FTOD/GameGirl-DEV-HD/README.md

GameGirl Development version is the GameGirl with power supply only from DEBUG port and USB-C.

This design is under CERN Open Hardware Licence Version 2 - Permissive license.
Please refer to [License.txt](license.txt) and [cern_ohl_p.v2.howto.pdf](cern_ohl_p_v2_howto.pdf) for more detail.
