FTOD/GameGirl-DEV-HD/GameGirl-dev.pdf

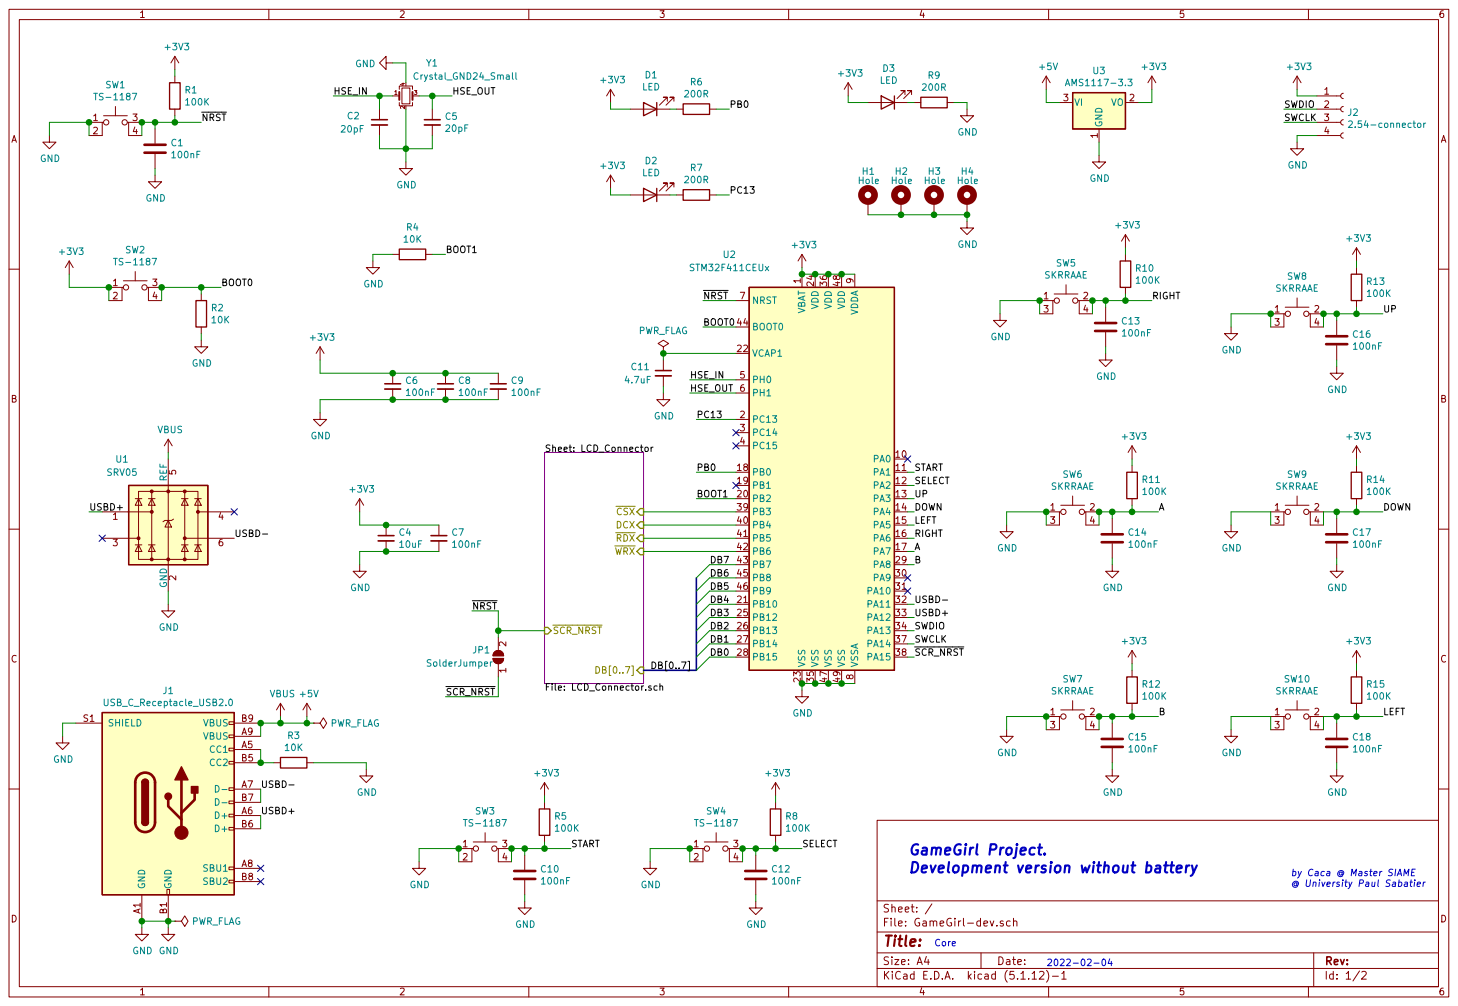
[picture p1: page 1]

1 VCAP1 22 VDD 24 VDD 36 VDD 48 VDDA

9 VSS 23 VSS 35 VSS 47 VSS 49 VSSA

LEFT SCR_NRST START B USBD+ USBD-

Development version without battery

by Caca @ Master SIAME
@ University Paul Sabatier

Id: 1/2 Title: File: GameGirl-dev.sch Sheet: /

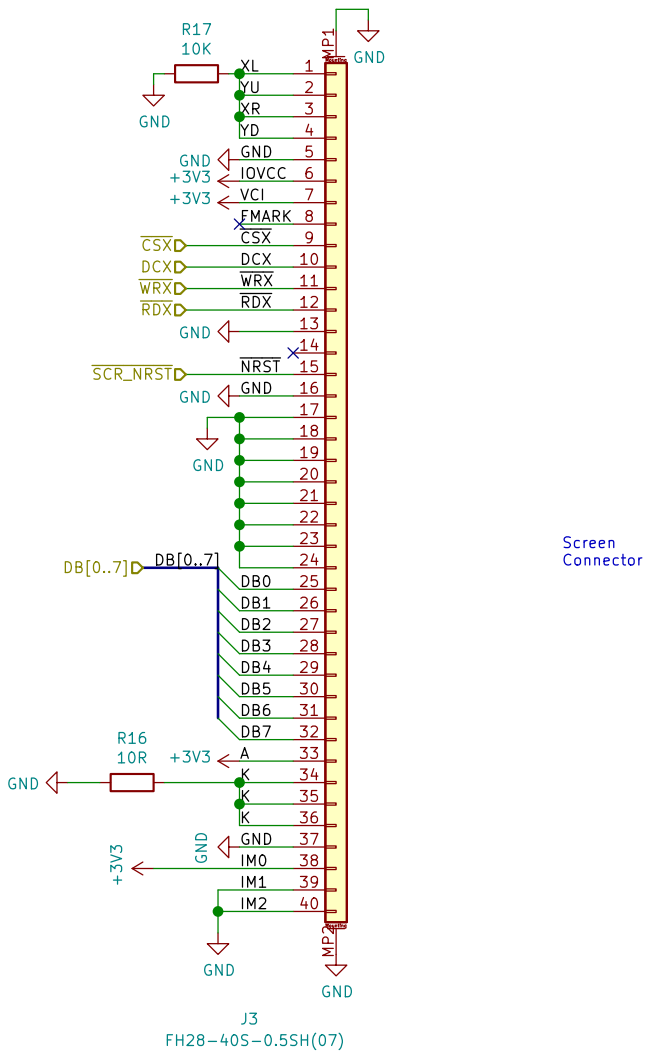
[picture p2: page 2]

GameGirl Project.
Development version without battery

by Caca @ Master SIAME
@ University Paul Sabatier
