FTOD/GameGirl-DEV-HD/GameGirl-dev.kicad_pcb

## KiCad design GameGirl-dev.kicad_pcb (2022-02-23)

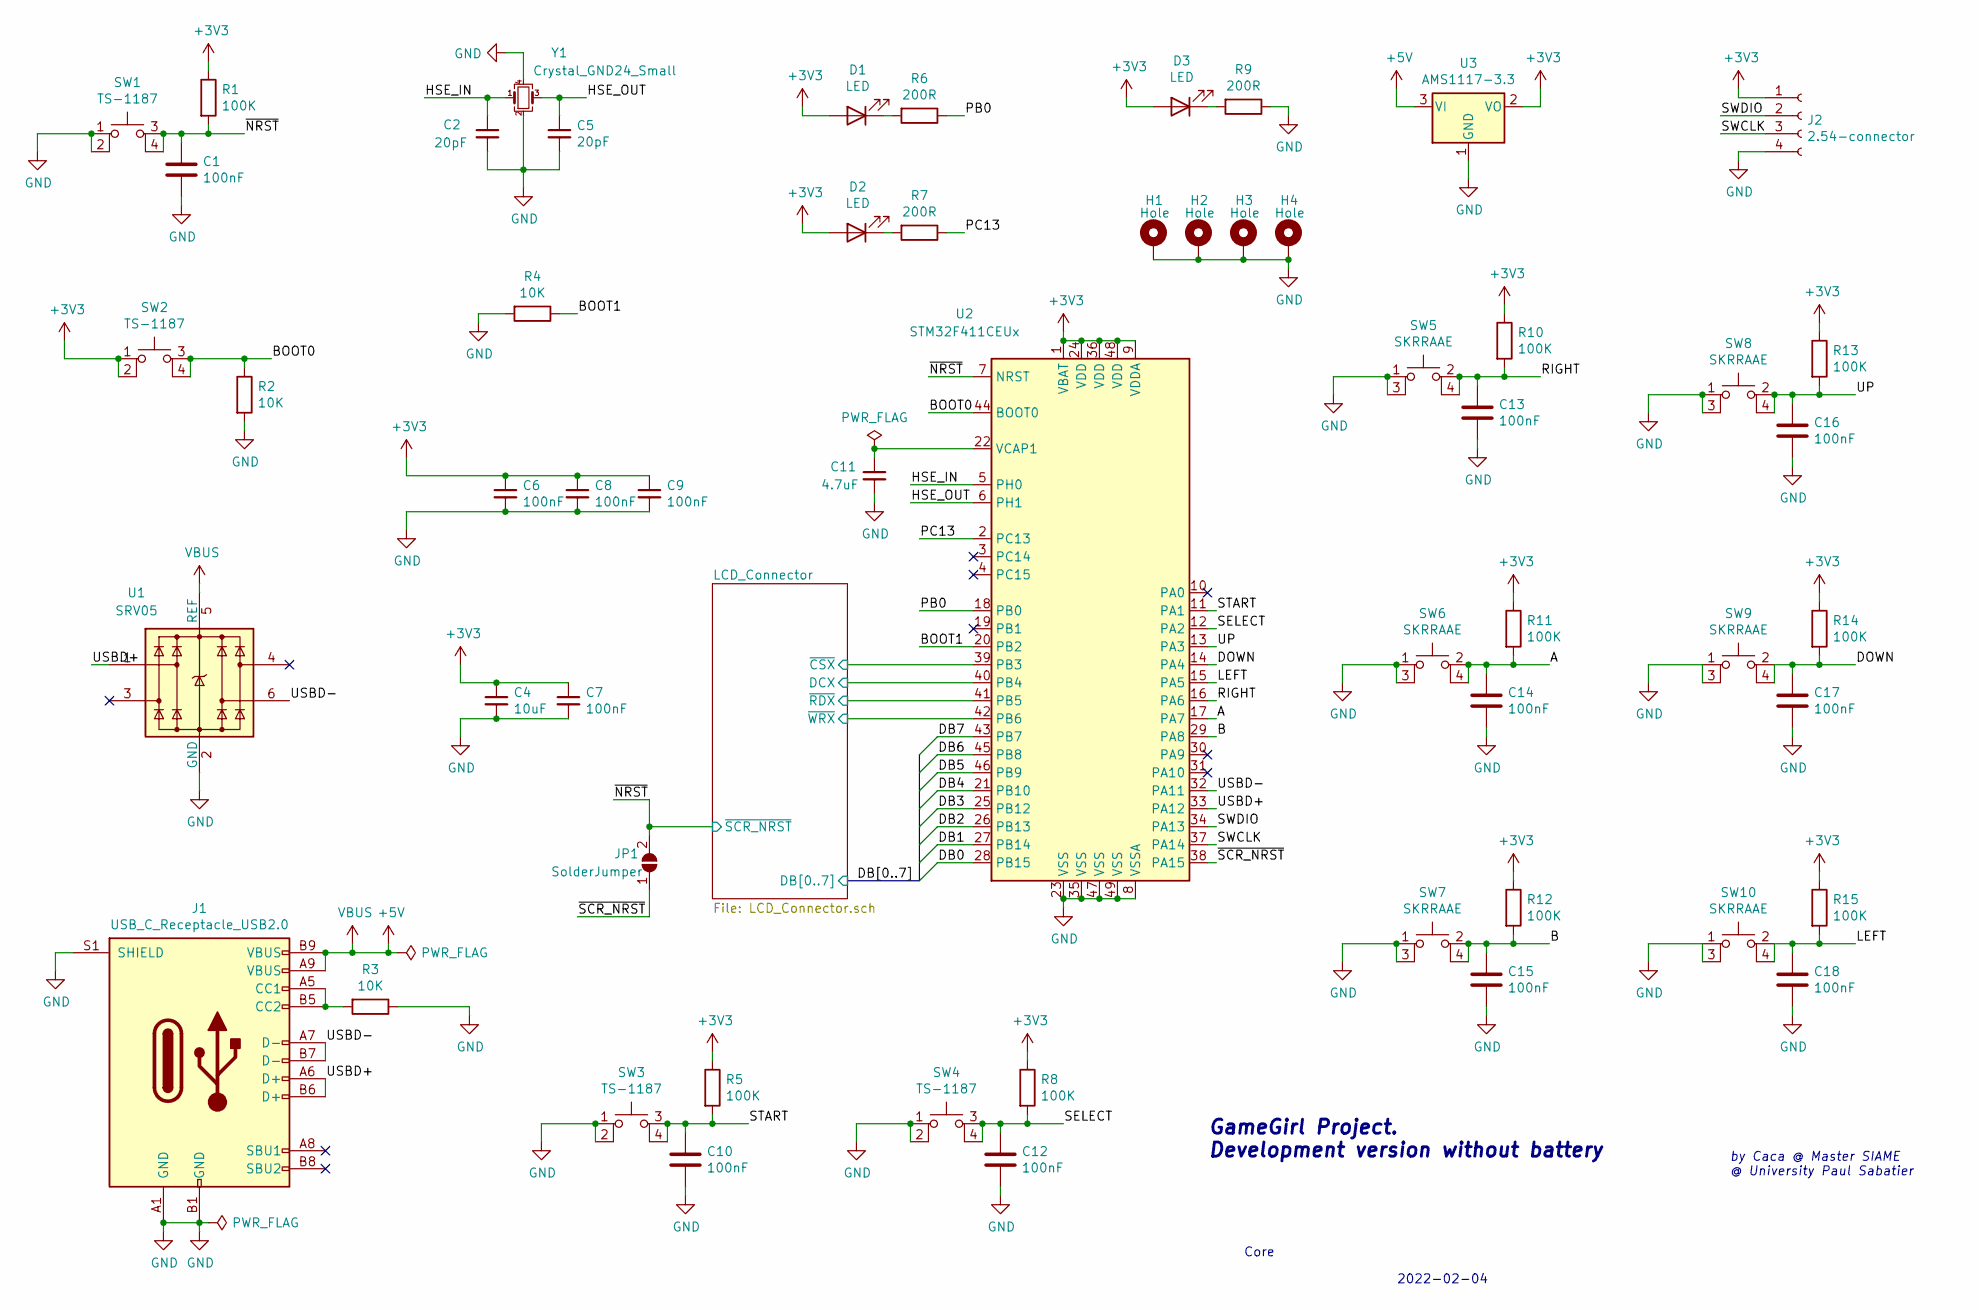
[picture p3: schematic GameGirl-dev.sch]

Parts:
C1, C6, C7, C8, C9, C10, C12, C13, C14, C15, C16, C17, C18: 100nF; C_0402_1005Metric
C2, C5: 20pF; C_0402_1005Metric
C4: 10uF; C_0805_2012Metric_Pad1.18x1.45mm_HandSolder
C11: 4.7uF; C_0805_2012Metric_Pad1.18x1.45mm_HandSolder
D1, D2: LED; LED_0603_1608Metric
D3: LED; LED_0805_2012Metric
H1, H2, H3, H4: Hole; MountingHole_3.2mm_M3_DIN965_Pad_TopBottom
J1: USB_C_Receptacle_USB2.0; USB_C_Receptacle_XKB_U262-16XN-4BVC11; LCSC C319148
J2: 2.54-connector; PinHeader_1x04_P2.54mm_Horizontal
JP1: SolderJumper; SolderJumper-2_P1.3mm_Open_TrianglePad1.0x1.5mm
R1, R5, R8, R10, R11, R12, R13, R14, R15: 100K; R_0402_1005Metric
R2, R3, R4: 10K; R_0402_1005Metric
R6, R7, R9: 200R; R_0402_1005Metric
SW1, SW2, SW3, SW4: TS-1187; TS1187ABAB; LCSC C318884
SW5, SW6, SW7, SW8, SW9, SW10: SKRRAAE; SKRR; LCSC C97437
U1: SRV05; SOT-23-6; LCSC C85364
U2: STM32F411CEUx; QFN-48-1EP_7x7mm_P0.5mm_EP5.6x5.6mm
U3: AMS1117-3.3; SOT-223
Y1: Crystal_GND24_Small; Crystal_SMD_3225-4Pin_3.2x2.5mm; LCSC C9006

Connections:
+3V3: C4.1, C6.1, C7.1, C8.1, C9.1, D1.2 (A), D2.2 (A), D3.2 (A), J2.1, R1.1, R5.1, R8.1, R10.1, R11.1, R12.1, R13.1, R14.1, R15.1, SW2.1 (A), SW2.2 (B), U2.1 (VBAT), U2.9 (VDDA), U2.24 (VDD), U2.36 (VDD), U2.48 (VDD), U3.2 (VO); also elsewhere on the board
+5V: J1.A4 (VBUS), J1.A9 (VBUS), J1.B4 (VBUS), J1.B9 (VBUS), U1.5 (REF), U3.3 (VI)
/A: C14.1, R11.2, SW6.2, SW6.4, U2.17 (PA7)
/B: C15.1, R12.2, SW7.2, SW7.4, U2.29 (PA8)
/BOOT0: R2.1, SW2.3 (C), SW2.4 (D), U2.44 (BOOT0)
/BOOT1: R4.1, U2.20 (PB2)
/DB0: U2.28 (PB15); also elsewhere on the board
/DB1: U2.27 (PB14); also elsewhere on the board
/DB2: U2.26 (PB13); also elsewhere on the board
/DB3: U2.25 (PB12); also elsewhere on the board
/DB4: U2.21 (PB10); also elsewhere on the board
/DB5: U2.46 (PB9); also elsewhere on the board
/DB6: U2.45 (PB8); also elsewhere on the board
/DB7: U2.43 (PB7); also elsewhere on the board
/DOWN: C17.1, R14.2, SW9.2, SW9.4, U2.14 (PA4)
/HSE_IN: C2.1, U2.5 (PH0), Y1.1
/HSE_OUT: C5.1, U2.6 (PH1), Y1.3
/LCD_Connector/DCX: U2.40 (PB4); also elsewhere on the board
/LCD_Connector/~CSX: U2.39 (PB3); also elsewhere on the board
/LCD_Connector/~RDX: U2.41 (PB5); also elsewhere on the board
/LCD_Connector/~WRX: U2.42 (PB6); also elsewhere on the board
/LEFT: C18.1, R15.2, SW10.2, SW10.4, U2.15 (PA5)
/PB0: R6.1, U2.18 (PB0)
/PC13: R7.1, U2.2 (PC13)
/RIGHT: C13.1, R10.2, SW5.2, SW5.4, U2.16 (PA6)
/SELECT: C12.1, R8.2, SW4.3 (C), SW4.4 (D), U2.12 (PA2)
/START: C10.1, R5.2, SW3.3 (C), SW3.4 (D), U2.11 (PA1)
/SWCLK: J2.3, U2.37 (PA14)
/SWDIO: J2.2, U2.34 (PA13)
/UP: C16.1, R13.2, SW8.2, SW8.4, U2.13 (PA3)
/USBD+: J1.A6 (D+), J1.B6 (D+), U1.1, U2.33 (PA12)
/USBD-: J1.A7 (D-), J1.B7 (D-), U1.6, U2.32 (PA11)
/~NRST: C1.1, JP1.2 (B), R1.2, SW1.3 (C), SW1.4 (D), U2.7 (NRST); also elsewhere on the board
/~SCR_NRST: JP1.1 (A), U2.38 (PA15)
GND: C1.2, C2.2, C4.2, C5.2, C6.2, C7.2, C8.2, C9.2, C10.2, C11.2, C12.2, C13.2, C14.2, C15.2, C16.2, C17.2, C18.2, H1.1, H2.1, H3.1, H4.1, J1.A1 (GND), J1.A12 (GND), J1.B1 (GND), J1.B12 (GND), J1.S1 (SHIELD), J2.4, R2.2, R3.1, R4.2, R9.1, SW1.1 (A), SW1.2 (B), SW3.1 (A), SW3.2 (B), SW4.1 (A), SW4.2 (B), SW5.1, SW5.3, SW6.1, SW6.3, SW7.1, SW7.3, SW8.1, SW8.3, SW9.1, SW9.3, SW10.1, SW10.3, U1.2 (GND), U2.8 (VSSA), U2.23 (VSS), U2.35 (VSS), U2.47 (VSS), U2.49 (VSS), U3.1 (GND), Y1.2, Y1.4; also elsewhere on the board
unnamed: C11.1, U2.22 (VCAP1)
unnamed: D1.1 (K), R6.2
unnamed: D2.1 (K), R7.2
unnamed: D3.1 (K), R9.2
unnamed: J1.A5 (CC1), J1.B5 (CC2), R3.2

Notes on the sheet:
GameGirl Project. Development version without battery
by Caca @ Master SIAME @ University Paul Sabatier
2022-02-04
Core

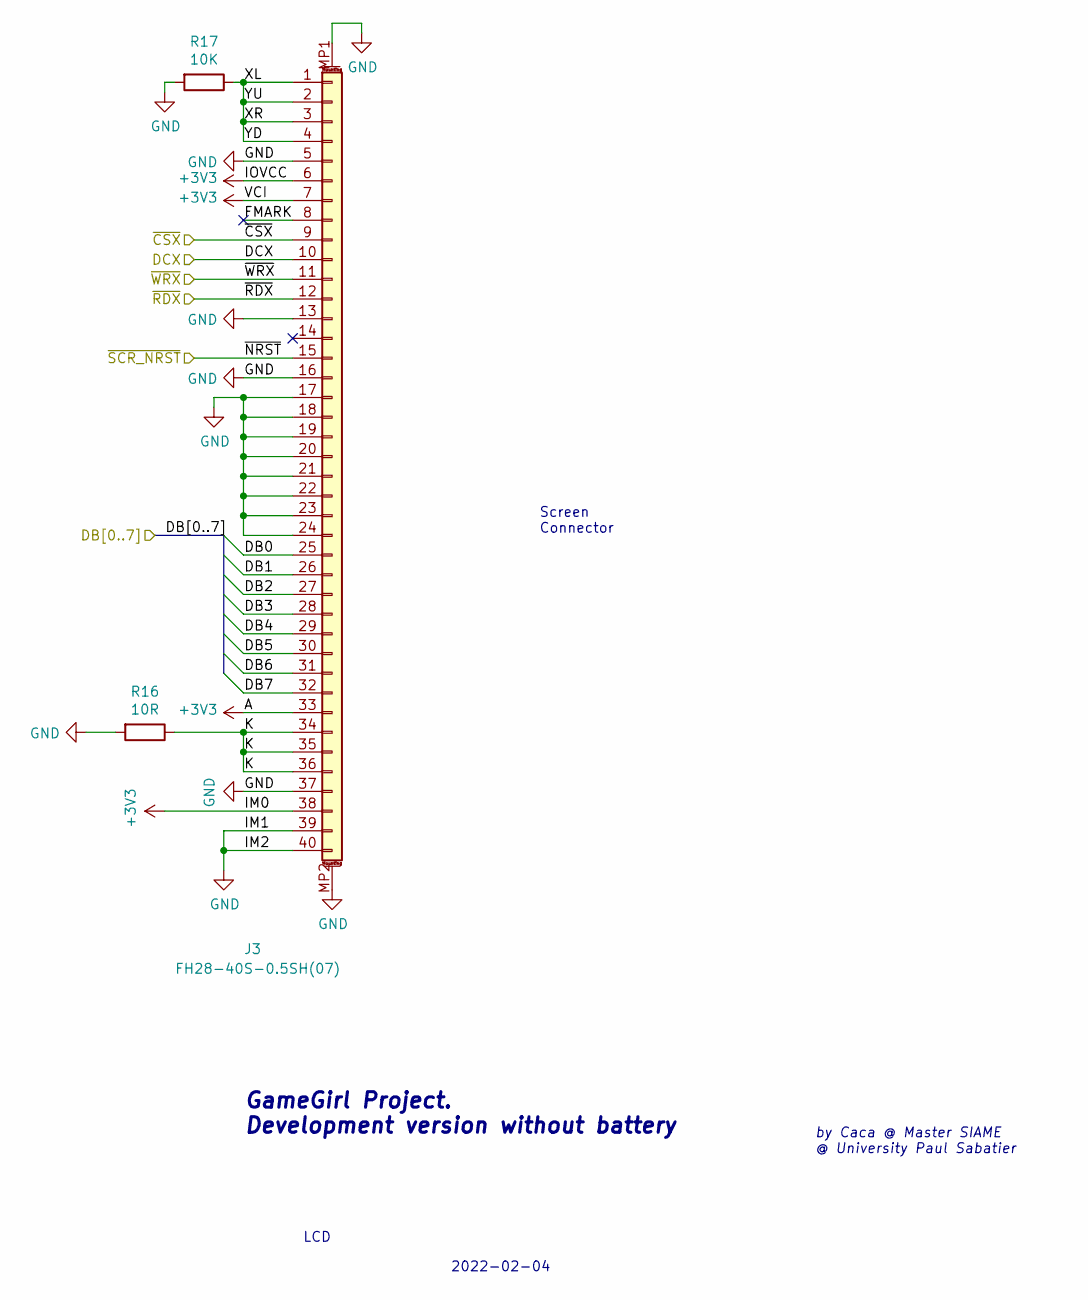
[picture p4: schematic LCD_Connector.sch]

Parts:
J3: FH28-40S-0.5SH(07); FH2840S05SH07; LCSC C424677
R16: 10R; R_0402_1005Metric
R17: 10K; R_0402_1005Metric

Connections:
+3V3: J3.6, J3.7, J3.33, J3.38; also elsewhere on the board
/DB0: J3.25; also elsewhere on the board
/DB1: J3.26; also elsewhere on the board
/DB2: J3.27; also elsewhere on the board
/DB3: J3.28; also elsewhere on the board
/DB4: J3.29; also elsewhere on the board
/DB5: J3.30; also elsewhere on the board
/DB6: J3.31; also elsewhere on the board
/DB7: J3.32; also elsewhere on the board
/LCD_Connector/DCX: J3.10; also elsewhere on the board
/LCD_Connector/FMARK: J3.8
/LCD_Connector/K: J3.34, J3.35, J3.36, R16.1
/LCD_Connector/XL: J3.1, J3.2, J3.3, J3.4, R17.1
/LCD_Connector/~CSX: J3.9; also elsewhere on the board
/LCD_Connector/~RDX: J3.12; also elsewhere on the board
/LCD_Connector/~WRX: J3.11; also elsewhere on the board
/~NRST: J3.15; also elsewhere on the board
GND: J3.5, J3.13, J3.16, J3.17, J3.18, J3.19, J3.20, J3.21, J3.22, J3.23, J3.24, J3.37, J3.39, J3.40, J3.MP1 (MountPin), J3.MP2 (MountPin), R16.2, R17.2; also elsewhere on the board

Notes on the sheet:
Screen Connector
GameGirl Project. Development version without battery
by Caca @ Master SIAME @ University Paul Sabatier
2022-02-04
LCD

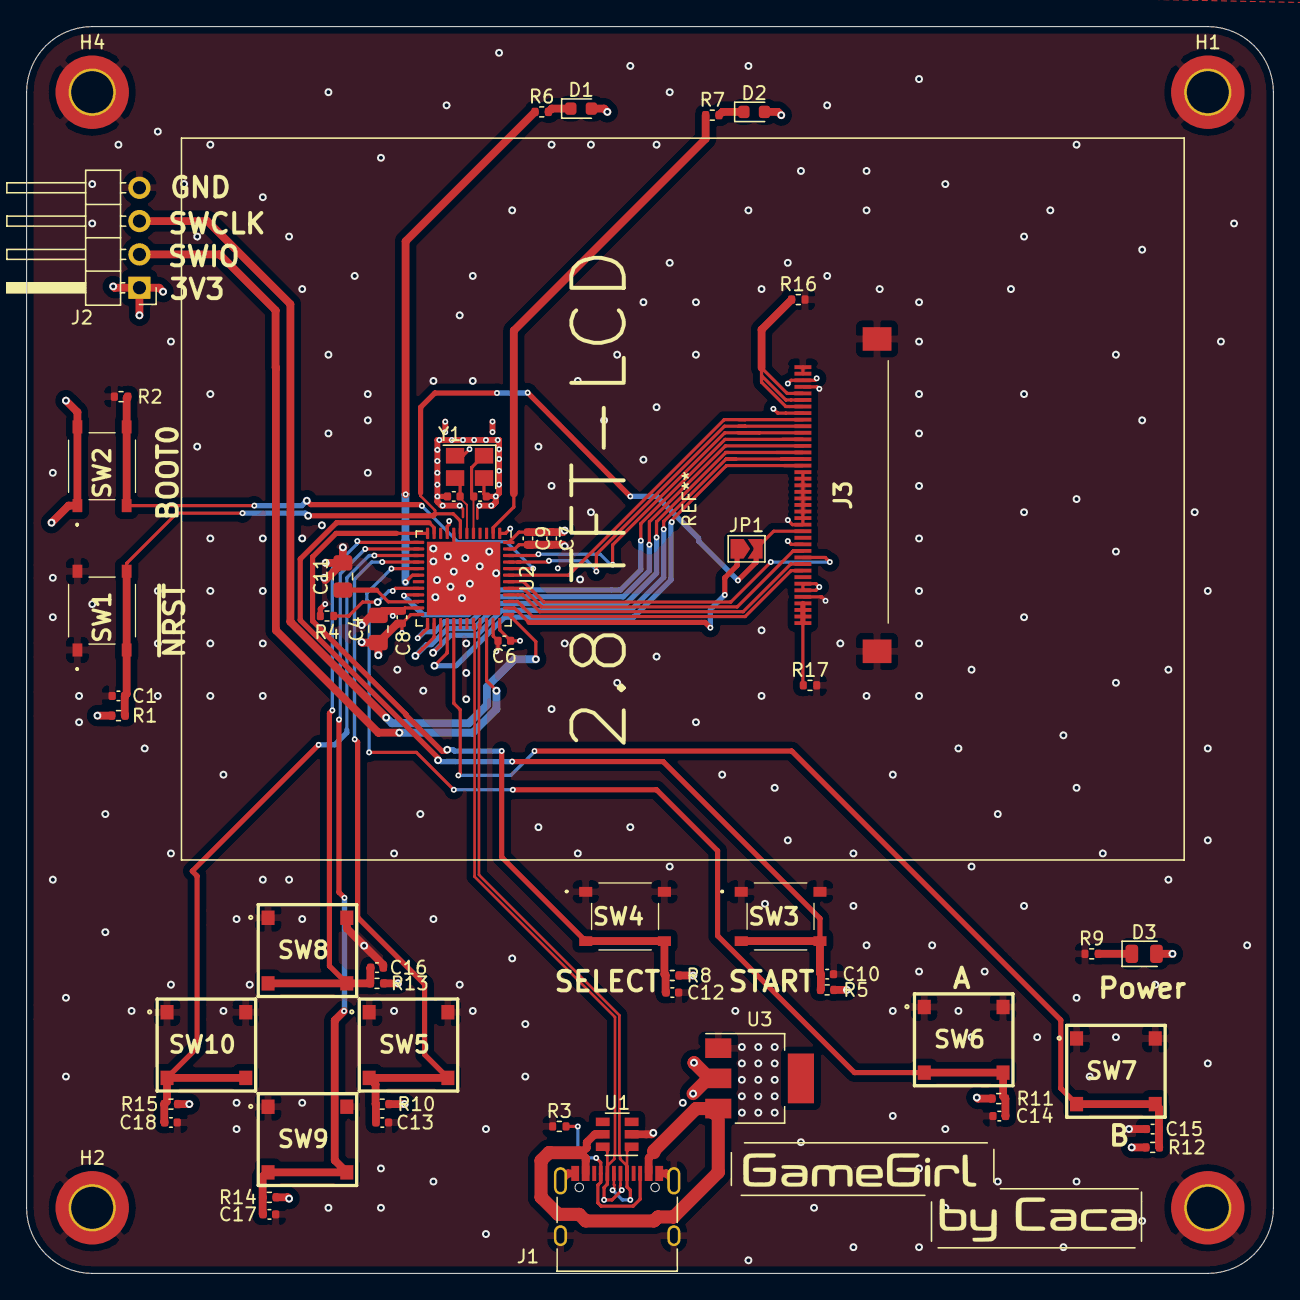
[picture p5: board GameGirl-dev.kicad_pcb from above]

Board: 4 copper layers, 95.0 x 95.0 mm, 59 parts (0 on the bottom side), 42 nets.
