FTOD/GameGirl-DEV-HD/(commit log)

2022-02-06 last modifs before fabrication
    [GameGirl-dev.kicad_pcb, GameGirl-dev.sch, LCD_Connector.sch]
2022-02-23 add schematic pdf, some changes to pcb
    [GameGirl-dev.kicad_pcb]
